Senpothia/automate-hardware/commandes/PCB_JLCPCB.pdf

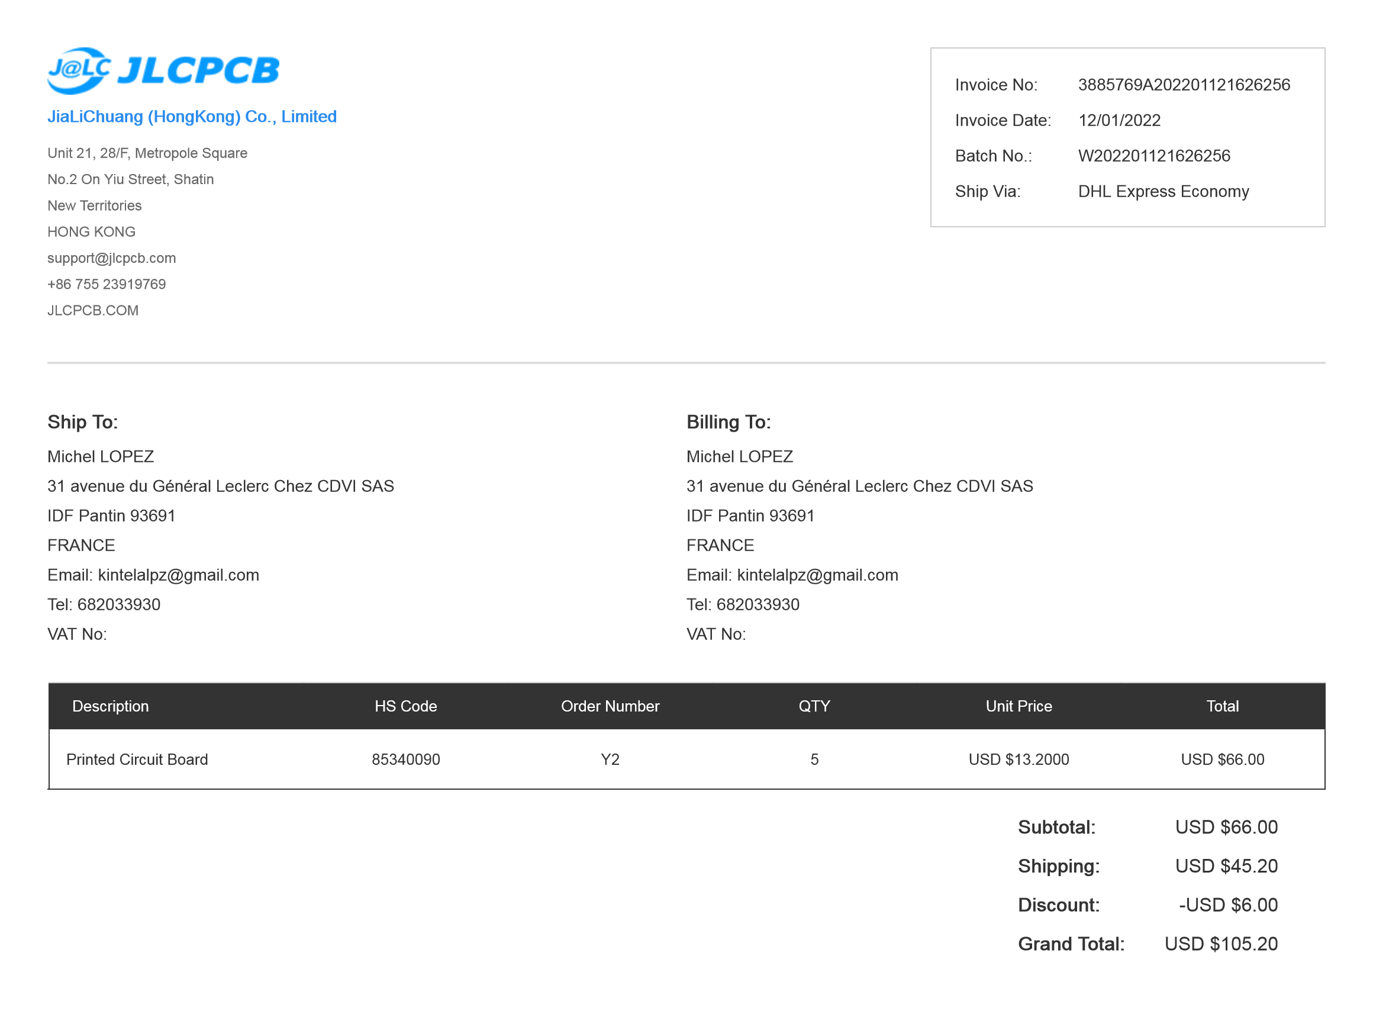
[picture p1: figure]
