Senpothia/automate-hardware/datasheet/microchip/PIC16F628A_Mod.png

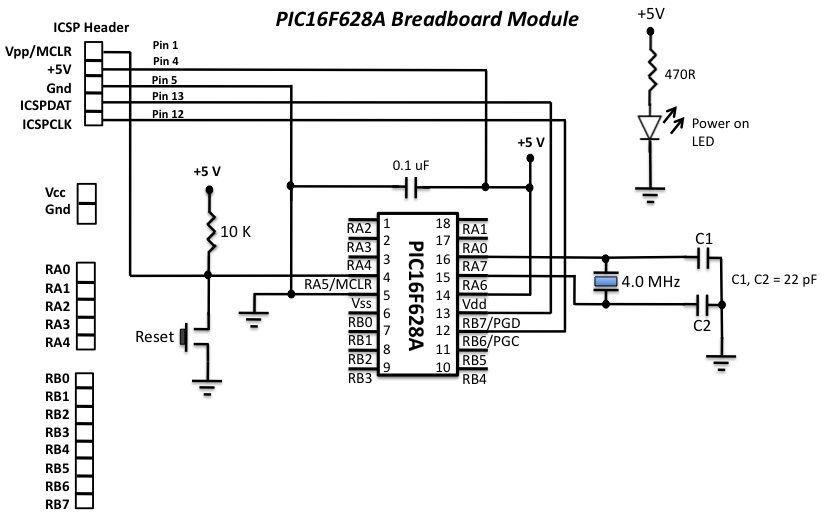
datasheet/microchip/PIC16F628A_Mod.png
