Senpothia/automate-hardware/datasheet/microchip/PICkit-ICSP-connector-to-PIC-chip-schematic.png

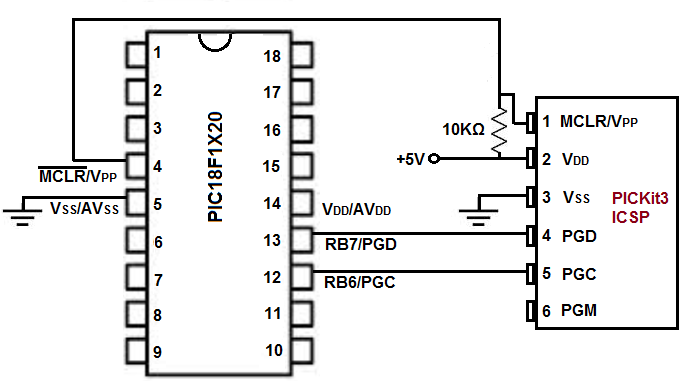
datasheet/microchip/PICkit-ICSP-connector-to-PIC-chip-schematic.png
