Senpothia/automate-hardware/version_qtfp.png

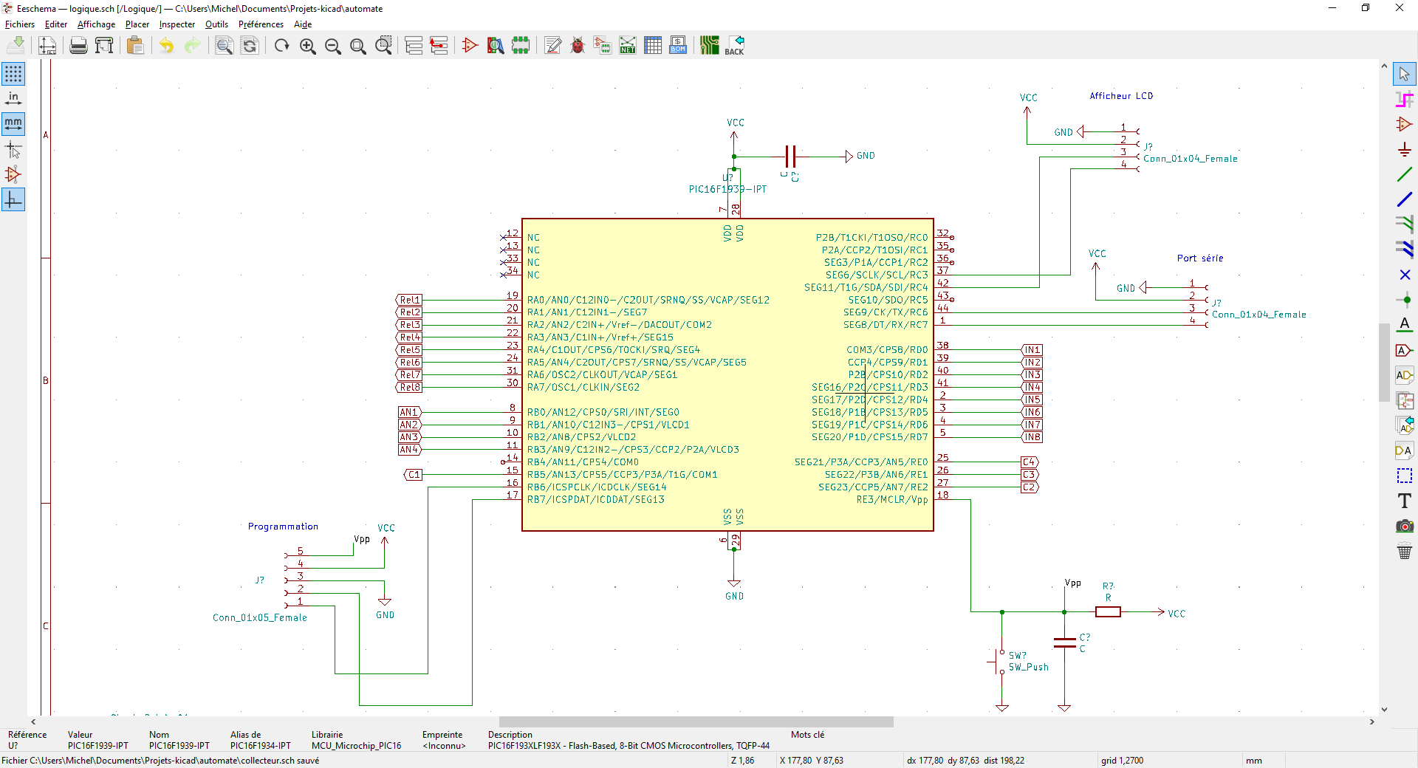
version_qtfp.png
