Senpothia/automate-hardware/brochage.ods

Label connecteur carte | Label schéma | Label carte | Pin PIC16F1939 | Interruptions | Remarques
J13 | IN1 | IN8 | 19
J14 | IN3 | IN7 | 21
J15 | IN2 | IN6 | 20
J16 | IN4 | IN5 | 22
J17 | IN5 | IN4 | 27
J18 | IN7 | IN3 | 29
J19 | IN6 | IN2 | 28
J20 | IN8 | IN1 | 30
J5 | K1 | K1 | 2
J6 | K2 | K2 | 3
J7 | K3 | K3 | 4
J8 | K4 | K4 | 5
J9 | K5 | K5 | 6
J10 | K6 | K6 | 7
J11 | K7 | K7 | 14
J12 | K8 | K8 | 13
J25-C1 | C1 | C1 | 38
J25-C2 | C2 | C2 | 10
J25-C3 | C4 | C3 | 9
J25-C4 | C3 | C4 | 8
J21 | AN1 | AN1 | 33 | INT /IOC PORTB
J22 | AN2 | AN2 | 34 | IOC PORTB
J23 | AN3 | AN3 | 35 | IOC PORTB
J24 | AN4 | AN4 | 36 | IOC PORTB
J4-pt3 | TX | RX | 25 |  | Erreur sérigraphie
J4-pt4 | RX | TX | 26 |  | Erreur sérigraphie
J3-pt4 | SCL | SCL | 18
J3-pt3 | SDA | SDA | 23
J26 – pt1 | GPIO1 | 0V | 15 |  | Erreur sérigraphie
J26 – pt2 | GPIO2 | 12V | 16 |  | Erreur sérigraphie
J26 – pt3 | GPIO3 | IO3 | 17 |  | Erreur sérigraphie
J26 – pt4 | GPIO4 | IO2 | 24 |  | Erreur sérigraphie
J26 – pt5 | +12V | IO1 | - |  | Erreur sérigraphie
 | BZ1/BZ2 | BZ1/BZ2 | 37
 | D43 | D43 | 37
J2 – pt1 |  | RB6 | 39 | IOC PORTB
J2 – pt2 |  | RB7 | 40 | IOC PORTB
