Senpothia/automate-hardware/datasheet/Panier_déc.31_1230.xls

PANIER
Ceci n'est pas une facture
31-déc.-21 12:30:27
 | N° Mouser | N° de fab. | Fabricant | N° client | Description | RoHS | Cycle de vie | Qté. | Prix (EUR) | Ext. : (EUR)
1 | 579-PIC16LF1939-I/P | PIC16LF1939-I/P | Microchip |  | Microcontrôleurs 8 bits - MCU 28KB Flash 1.8-5.5V 1KB RAM 256B EEPROM | RoHS : conforme |  | 5 | 2,63 € | 13,15 €
2 | 584-LT1376CS8#PBF | LT1376CS8#PBF | Analog Devices Inc. |  | Régulateurs de tension de commutation 500kHz 1.5A S/D Sw Reg. | RoHS : conforme |  | 4 | 7,87 € | 31,48 €
3 | 771-BC817K-16HR | BC817K-16HR | Nexperia |  | Transistors bipolaires - BJT TRANS BIPOLAR | RoHS : conforme |  | 50 | 0,173 € | 8,65 €
4 | 652-SMBJ150A-QH | SMBJ150A-QH | Bourns |  | Suppresseurs ESD / diodes TVS DIO TVS VRWM 150V 600W UNIDIR SMB AECQ | RoHS : conforme | Nouveau produit | 20 | 0,336 € | 6,72 €
5 | 512-SSA36 | SSA36 | onsemi |  | Diodes et redresseurs Schottky 3A, 60V SMA SCHOTTKY BARRIER RECTIFIER | Conforme à RoHS par dispense |  | 20 | 0,412 € | 8,24 €
En soumettant votre commande, vous acceptez ces conditions. (https://www.mouser.fr/saleterms) |  |  |  |  |  |  |  |  | Marchandise : | 68,24 €
Les prix sont ceux de la date et de l'heure indiquées. |  |  |  |  |  |  |  |  | Frais d'expédition : | 0,00 €
