Senpothia/automate-hardware/automate.kicad_pcb

## KiCad design automate.kicad_pcb (2022-02-25)

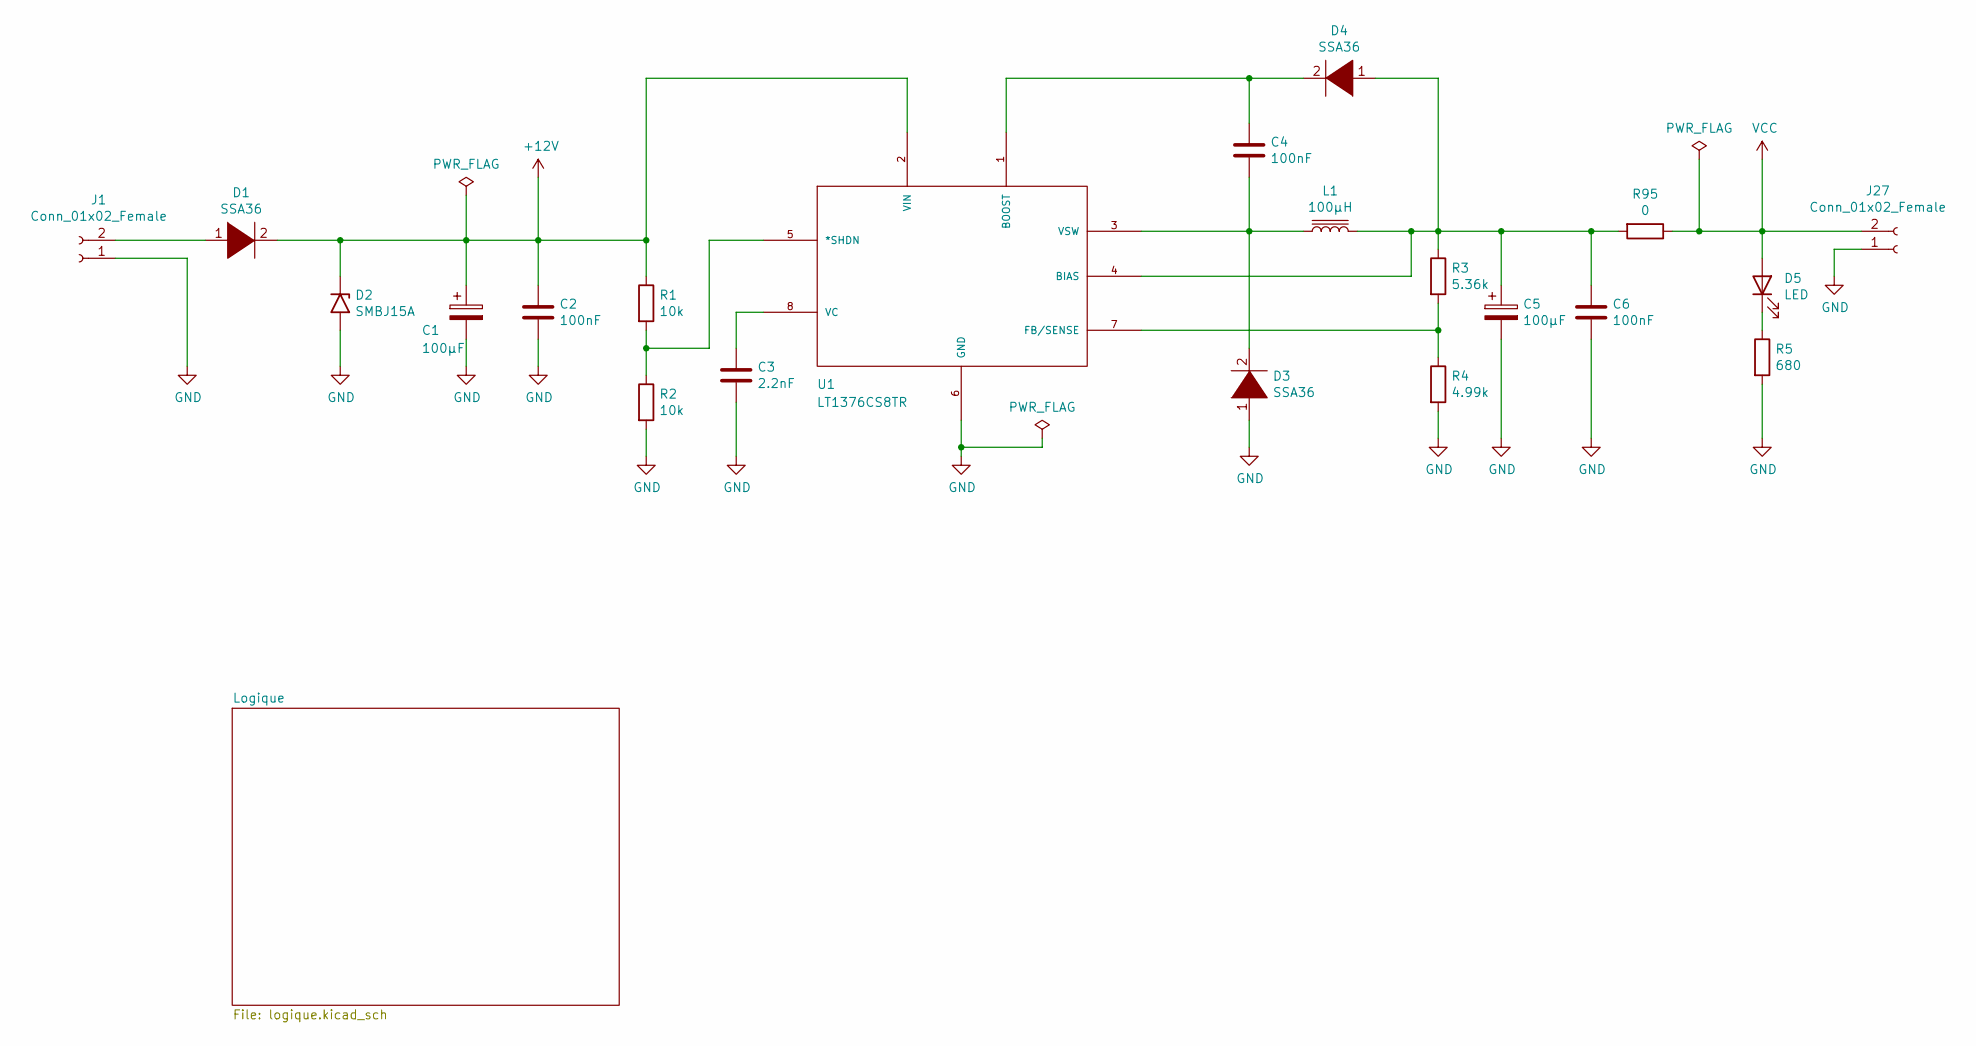
[picture p5: schematic automate.kicad_sch]

Parts:
C1, C5: 100µF; C_Elec_8x6.2
C2, C4, C6: 100nF; R_0805_2012Metric_Pad1.20x1.40mm_HandSolder
C3: 2.2nF; R_0805_2012Metric_Pad1.20x1.40mm_HandSolder
D1, D3, D4: SSA36; D_SMB_SSA36-Handsoldering
D2: SMBJ15A; D_SMB_Handsoldering
D5: LED; D_0805_2012Metric_Pad1.15x1.40mm_HandSolder
J1, J27: Conn_01x02_Female; conn-2pts-P5mm
L1: 100µH; L_Wuerth_WE-PD-Typ-LS-12x12
R1, R2: 10k; R_0805_2012Metric_Pad1.20x1.40mm_HandSolder
R3: 5.36k; R_0805_2012Metric_Pad1.20x1.40mm_HandSolder
R4: 4.99k; R_0805_2012Metric_Pad1.20x1.40mm_HandSolder
R5: 680; R_0805_2012Metric_Pad1.20x1.40mm_HandSolder
R95: 0; R_1206_3216Metric_Pad1.30x1.75mm_HandSolder
U1: LT1376CS8TR; SOIC-8_3.9x4.9mm_P1.27mm; MANUFACTURER_PART_NUMBER lt1376cs8#tr

Connections:
+12V: C1.1, C2.1, D1.2 (A), D2.1 (A1), R1.1, U1.2 (VIN); also elsewhere on the board
GND: C1.2, C2.2, C3.2, C5.2, C6.2, D2.2 (A2), D3.1 (K), J1.1, J27.1, R2.2, R4.2, R5.2, U1.6 (GND); also elsewhere on the board
unnamed: C3.1, U1.8 (VC)
unnamed: C4.1, D4.2 (A), U1.1 (BOOST)
unnamed: C4.2, D3.2 (A), L1.1, U1.3 (VSW)
unnamed: C5.1, C6.1, D4.1 (K), L1.2, R3.1, R95.2, U1.4 (BIAS)
unnamed: D1.1 (K), J1.2
unnamed: D5.1 (K), R5.1
unnamed: R1.2, R2.1, U1.5 (*SHDN)
unnamed: R3.2, R4.1, U1.7 (FB/SENSE)
VCC: D5.2 (A), J27.2, R95.1; also elsewhere on the board

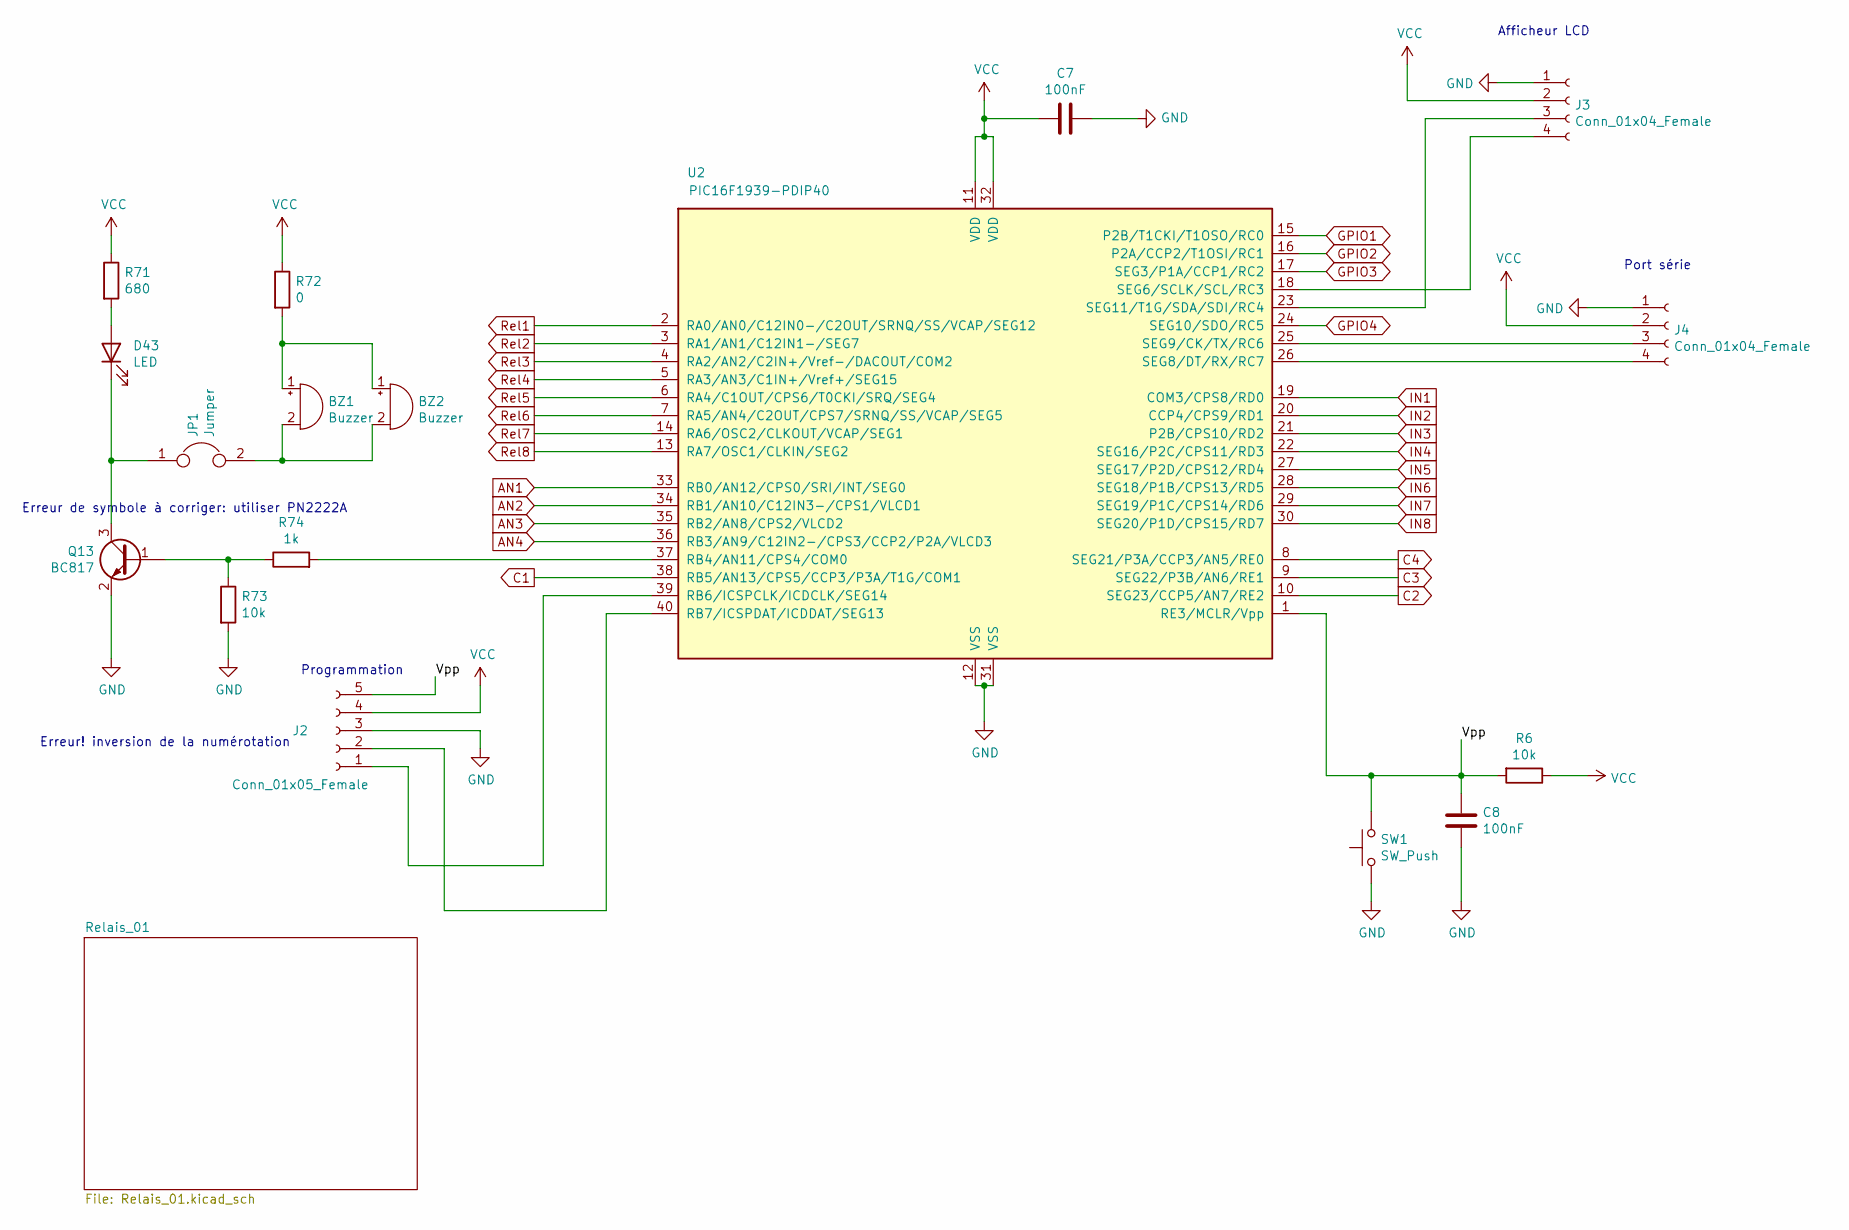
[picture p6: schematic logique.kicad_sch]

Parts:
BZ1: Buzzer; Buzzer_Mallory_AST1109MLTRQ
BZ2: Buzzer; Buzzer_12x9.5RM7.6
C7, C8: 100nF; R_0805_2012Metric_Pad1.20x1.40mm_HandSolder
D43: LED; LED_0805_2012Metric_Pad1.15x1.40mm_HandSolder
J2: Conn_01x05_Female; PinHeader_1x05_P2.54mm_Vertical
J3, J4: Conn_01x04_Female; conn-4pts-P5mm
JP1: Jumper; PinHeader_1x02_P2.54mm_Vertical
Q13: BC817; SOT-23.-BC817kicad_mod
R6, R73: 10k; R_0805_2012Metric_Pad1.20x1.40mm_HandSolder
R71: 680; R_0805_2012Metric_Pad1.20x1.40mm_HandSolder
R72: 0; R_0805_2012Metric_Pad1.20x1.40mm_HandSolder
R74: 1k; R_0805_2012Metric_Pad1.20x1.40mm_HandSolder
SW1: SW_Push; SW_PUSH_6mm_H5mm
U2: PIC16F1939-PDIP40; DIP-40_W15.24mm_LongPads

Connections:
/Logique/Vpp: C8.1, J2.5, R6.2, SW1.2, U2.1 (RE3/MCLR/Vpp)
AN1: U2.33 (RB0/AN12/CPS0/SRI/INT/SEG0); also elsewhere on the board
AN2: U2.34 (RB1/AN10/C12IN3-/CPS1/VLCD1); also elsewhere on the board
AN3: U2.35 (RB2/AN8/CPS2/VLCD2); also elsewhere on the board
AN4: U2.36 (RB3/AN9/C12IN2-/CPS3/CCP2/P2A/VLCD3); also elsewhere on the board
C1: U2.38 (RB5/AN13/CPS5/CCP3/P3A/T1G/COM1); also elsewhere on the board
C2: U2.10 (SEG23/CCP5/AN7/RE2); also elsewhere on the board
C3: U2.9 (SEG22/P3B/AN6/RE1); also elsewhere on the board
C4: U2.8 (SEG21/P3A/CCP3/AN5/RE0); also elsewhere on the board
GND: C7.1, C8.2, J2.3, J3.1, J4.1, Q13.2 (E), R73.2, SW1.1, U2.12 (VSS), U2.31 (VSS); also elsewhere on the board
GPIO1: U2.15 (P2B/T1CKI/T1OSO/RC0); also elsewhere on the board
GPIO2: U2.16 (P2A/CCP2/T1OSI/RC1); also elsewhere on the board
GPIO3: U2.17 (SEG3/P1A/CCP1/RC2); also elsewhere on the board
GPIO4: U2.24 (SEG10/SDO/RC5); also elsewhere on the board
IN1: U2.19 (COM3/CPS8/RD0); also elsewhere on the board
IN2: U2.20 (CCP4/CPS9/RD1); also elsewhere on the board
IN3: U2.21 (P2B/CPS10/RD2); also elsewhere on the board
IN4: U2.22 (SEG16/P2C/CPS11/RD3); also elsewhere on the board
IN5: U2.27 (SEG17/P2D/CPS12/RD4); also elsewhere on the board
IN6: U2.28 (SEG18/P1B/CPS13/RD5); also elsewhere on the board
IN7: U2.29 (SEG19/P1C/CPS14/RD6); also elsewhere on the board
IN8: U2.30 (SEG20/P1D/CPS15/RD7); also elsewhere on the board
unnamed: BZ1.1 (-), BZ2.1 (-), R72.2
unnamed: BZ1.2 (+), BZ2.2 (+), JP1.2
unnamed: D43.1 (K), JP1.1, Q13.3 (C)
unnamed: D43.2 (A), R71.2
unnamed: J2.1, U2.39 (RB6/ICSPCLK/ICDCLK/SEG14)
unnamed: J2.2, U2.40 (RB7/ICSPDAT/ICDDAT/SEG13)
unnamed: J3.3, U2.23 (SEG11/T1G/SDA/SDI/RC4)
unnamed: J3.4, U2.18 (SEG6/SCLK/SCL/RC3)
unnamed: J4.3, U2.25 (SEG9/CK/TX/RC6)
unnamed: J4.4, U2.26 (SEG8/DT/RX/RC7)
unnamed: Q13.1 (B), R73.1, R74.1
unnamed: R74.2, U2.37 (RB4/AN11/CPS4/COM0)
Rel1: U2.2 (RA0/AN0/C12IN0-/C2OUT/SRNQ/SS/VCAP/SEG12); also elsewhere on the board
Rel2: U2.3 (RA1/AN1/C12IN1-/SEG7); also elsewhere on the board
Rel3: U2.4 (RA2/AN2/C2IN+/Vref-/DACOUT/COM2); also elsewhere on the board
Rel4: U2.5 (RA3/AN3/C1IN+/Vref+/SEG15); also elsewhere on the board
Rel5: U2.6 (RA4/C1OUT/CPS6/T0CKI/SRQ/SEG4); also elsewhere on the board
Rel6: U2.7 (RA5/AN4/C2OUT/CPS7/SRNQ/SS/VCAP/SEG5); also elsewhere on the board
Rel7: U2.14 (RA6/OSC2/CLKOUT/VCAP/SEG1); also elsewhere on the board
Rel8: U2.13 (RA7/OSC1/CLKIN/SEG2); also elsewhere on the board
VCC: C7.2, J2.4, J3.2, J4.2, R6.1, R71.1, R72.1, U2.11 (VDD), U2.32 (VDD); also elsewhere on the board

Notes on the sheet:
Erreur! inversion de la numérotation
Afficheur LCD
Port série
Programmation
Erreur de symbole à corriger: utiliser PN2222A

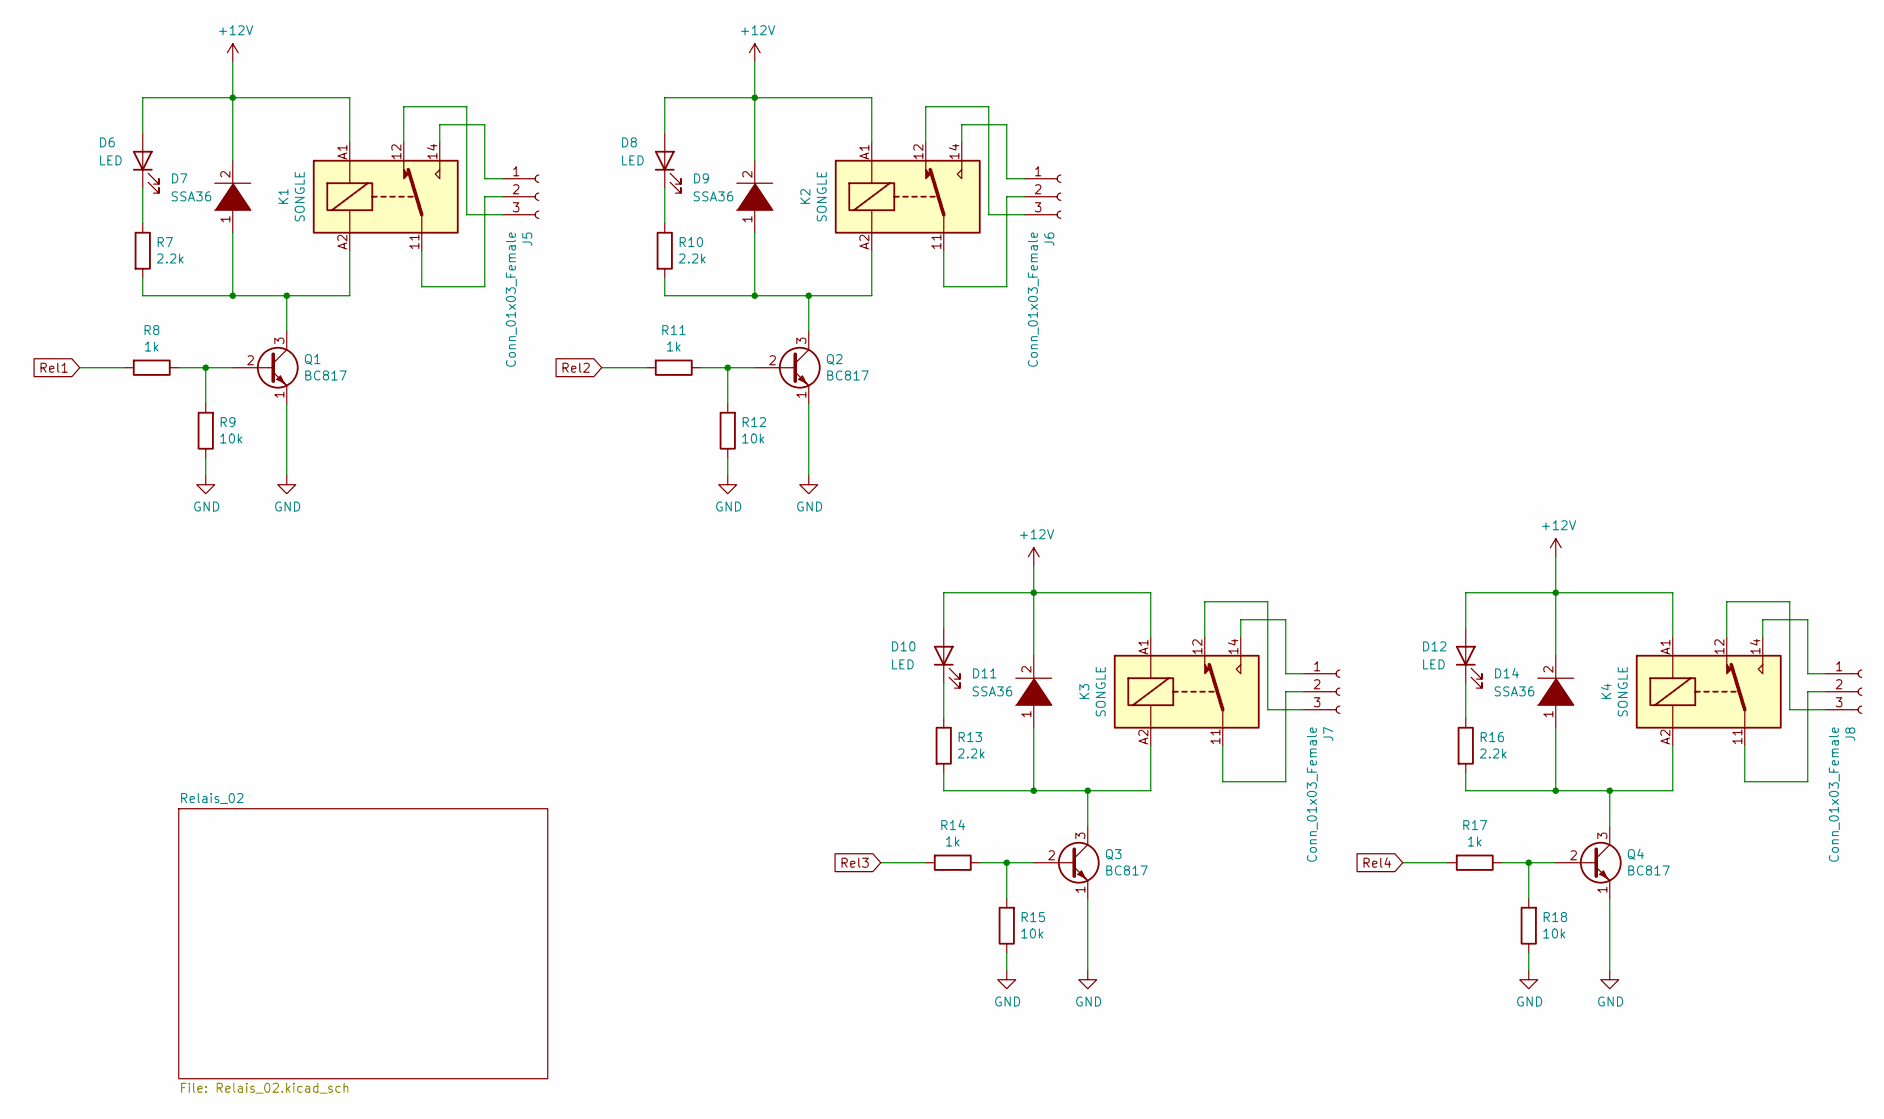
[picture p7: schematic Relais_01.kicad_sch]

Parts:
D6, D8, D10, D12: LED; D_0805_2012Metric_Pad1.15x1.40mm_HandSolder
D7, D9, D11: SSA36; D_SMB_SSA36-Handsoldering
D14: SSA36; D_SMB_Handsoldering
J5, J6, J7, J8: Conn_01x03_Female; conn-3pts-P5mm
K1, K2, K3, K4: SONGLE; Relay_SRD_Series_Form_C
Q1, Q2, Q3, Q4: BC817; SOT-23.-BC817kicad_mod
R7, R10, R13, R16: 2.2k; R_0805_2012Metric_Pad1.20x1.40mm_HandSolder
R8, R11, R14, R17: 1k; R_0805_2012Metric_Pad1.20x1.40mm_HandSolder
R9, R12, R15, R18: 10k; R_0805_2012Metric_Pad1.20x1.40mm_HandSolder

Connections:
+12V: D6.2 (A), D7.2 (A), D8.2 (A), D9.2 (A), D10.2 (A), D11.2 (A), D12.2 (A), D14.2 (A), K1.A1, K2.A1, K3.A1, K4.A1; also elsewhere on the board
GND: Q1.1 (E), Q2.1 (E), Q3.1 (E), Q4.1 (E), R9.1, R12.1, R15.1, R18.1; also elsewhere on the board
unnamed: D6.1 (K), R7.1
unnamed: D7.1 (K), K1.A2, Q1.3 (C), R7.2
unnamed: D8.1 (K), R10.1
unnamed: D9.1 (K), K2.A2, Q2.3 (C), R10.2
unnamed: D10.1 (K), R13.1
unnamed: D11.1 (K), K3.A2, Q3.3 (C), R13.2
unnamed: D12.1 (K), R16.1
unnamed: D14.1 (K), K4.A2, Q4.3 (C), R16.2
unnamed: J5.1, K1.14
unnamed: J5.2, K1.11
unnamed: J5.3, K1.12
unnamed: J6.1, K2.14
unnamed: J6.2, K2.11
unnamed: J6.3, K2.12
unnamed: J7.1, K3.14
unnamed: J7.2, K3.11
unnamed: J7.3, K3.12
unnamed: J8.1, K4.14
unnamed: J8.2, K4.11
unnamed: J8.3, K4.12
unnamed: Q1.2 (B), R8.1, R9.2
unnamed: Q2.2 (B), R11.1, R12.2
unnamed: Q3.2 (B), R14.1, R15.2
unnamed: Q4.2 (B), R17.1, R18.2
Rel1: R8.2; also elsewhere on the board
Rel2: R11.2; also elsewhere on the board
Rel3: R14.2; also elsewhere on the board
Rel4: R17.2; also elsewhere on the board

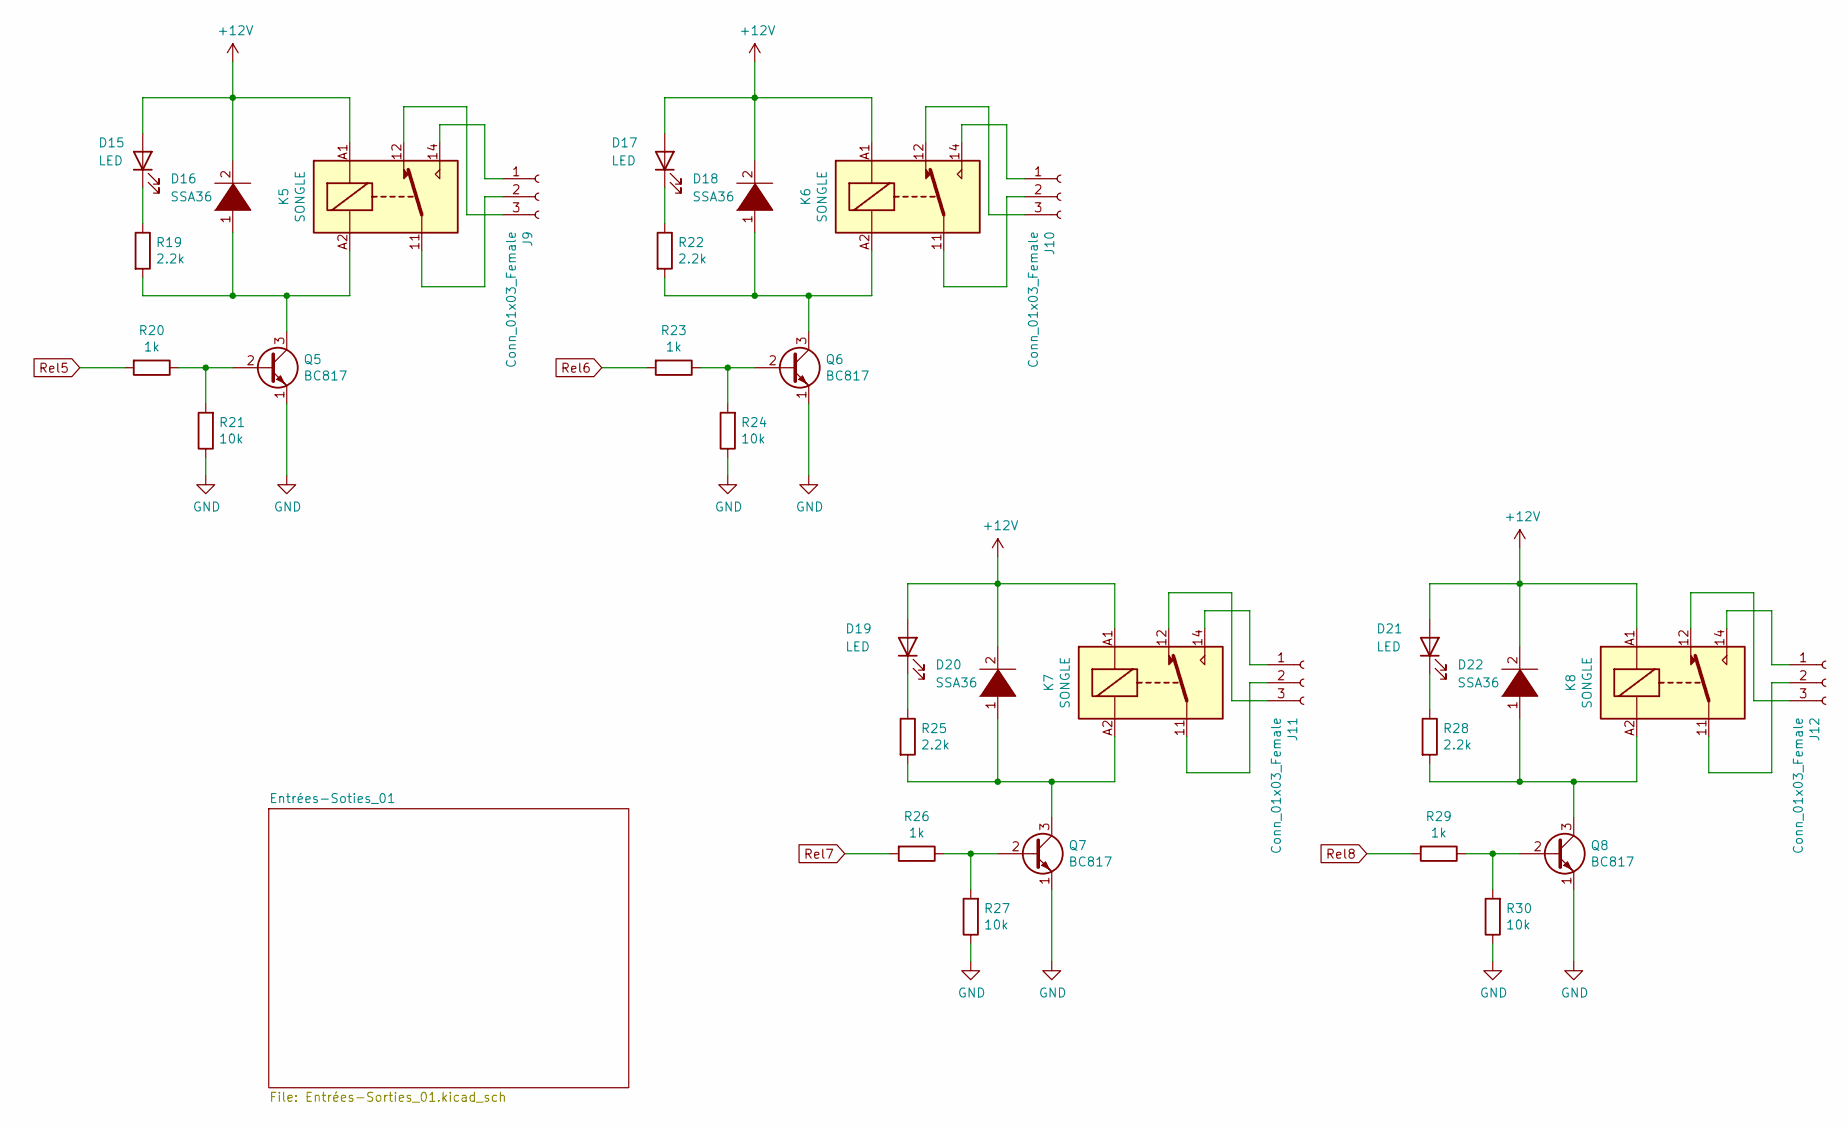
[picture p8: schematic Relais_02.kicad_sch]

Parts:
D15, D17, D19, D21: LED; D_0805_2012Metric_Pad1.15x1.40mm_HandSolder
D16, D18, D20, D22: SSA36; D_SMB_SSA36-Handsoldering
J9, J10, J11, J12: Conn_01x03_Female; conn-3pts-P5mm
K5, K6, K7, K8: SONGLE; Relay_SRD_Series_Form_C
Q5, Q6, Q7, Q8: BC817; SOT-23.-BC817kicad_mod
R19, R22, R25, R28: 2.2k; R_0805_2012Metric_Pad1.20x1.40mm_HandSolder
R20, R23, R26, R29: 1k; R_0805_2012Metric_Pad1.20x1.40mm_HandSolder
R21, R24, R27, R30: 10k; R_0805_2012Metric_Pad1.20x1.40mm_HandSolder

Connections:
+12V: D15.2 (A), D16.2 (A), D17.2 (A), D18.2 (A), D19.2 (A), D20.2 (A), D21.2 (A), D22.2 (A), K5.A1, K6.A1, K7.A1, K8.A1; also elsewhere on the board
GND: Q5.1 (E), Q6.1 (E), Q7.1 (E), Q8.1 (E), R21.1, R24.1, R27.1, R30.1; also elsewhere on the board
unnamed: D15.1 (K), R19.1
unnamed: D16.1 (K), K5.A2, Q5.3 (C), R19.2
unnamed: D17.1 (K), R22.1
unnamed: D18.1 (K), K6.A2, Q6.3 (C), R22.2
unnamed: D19.1 (K), R25.1
unnamed: D20.1 (K), K7.A2, Q7.3 (C), R25.2
unnamed: D21.1 (K), R28.1
unnamed: D22.1 (K), K8.A2, Q8.3 (C), R28.2
unnamed: J9.1, K5.14
unnamed: J9.2, K5.11
unnamed: J9.3, K5.12
unnamed: J10.1, K6.14
unnamed: J10.2, K6.11
unnamed: J10.3, K6.12
unnamed: J11.1, K7.14
unnamed: J11.2, K7.11
unnamed: J11.3, K7.12
unnamed: J12.1, K8.14
unnamed: J12.2, K8.11
unnamed: J12.3, K8.12
unnamed: Q5.2 (B), R20.1, R21.2
unnamed: Q6.2 (B), R23.1, R24.2
unnamed: Q7.2 (B), R26.1, R27.2
unnamed: Q8.2 (B), R29.1, R30.2
Rel5: R20.2; also elsewhere on the board
Rel6: R23.2; also elsewhere on the board
Rel7: R26.2; also elsewhere on the board
Rel8: R29.2; also elsewhere on the board

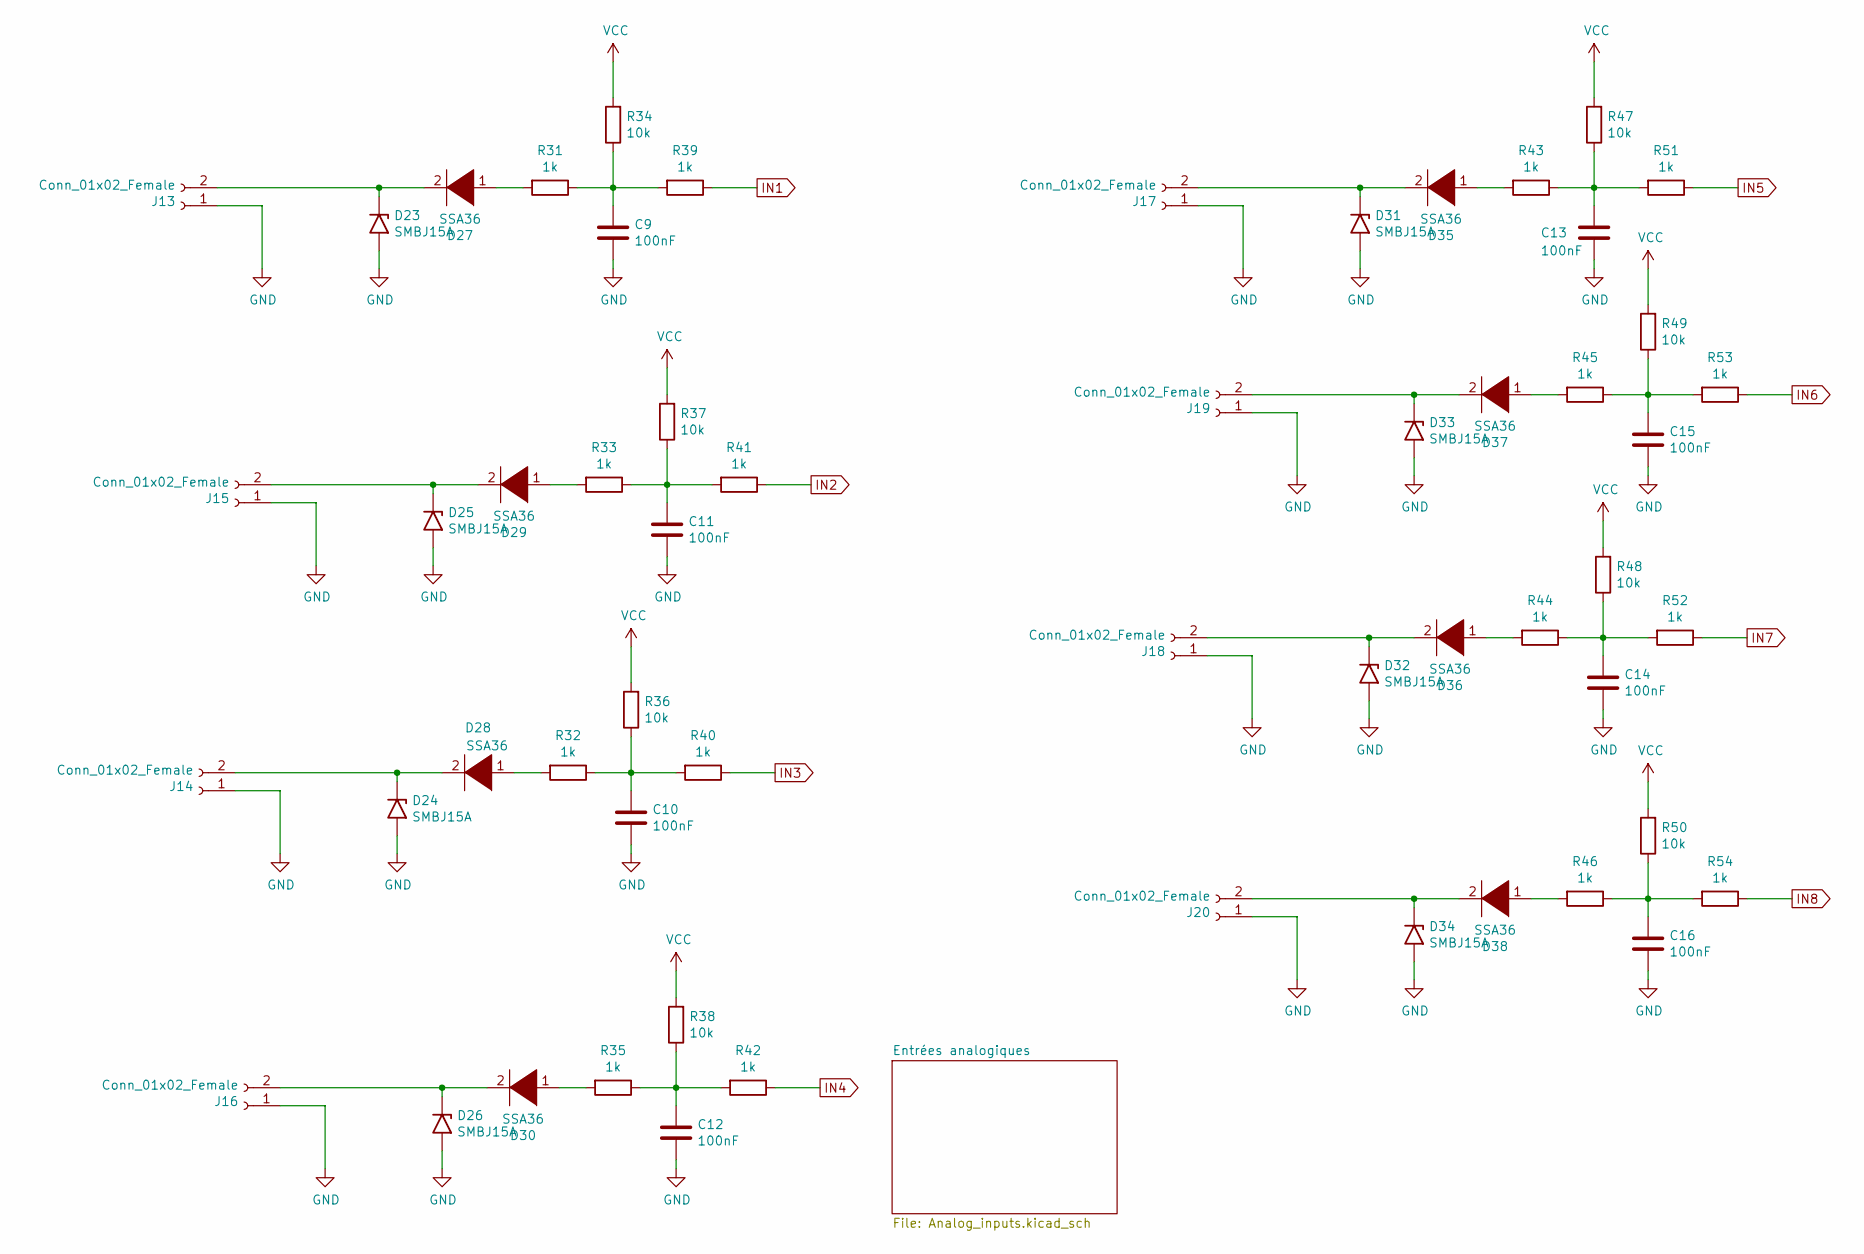
[picture p9: schematic Entrées-Sorties_01.kicad_sch]

Parts:
C9, C10, C11, C12, C13, C14, C15, C16: 100nF; R_0805_2012Metric_Pad1.20x1.40mm_HandSolder
D23, D24, D25, D26, D31, D32, D33, D34: SMBJ15A; D_SMB_Handsoldering
D27, D28, D29, D30, D35, D36, D37, D38: SSA36; D_SMB_SSA36-Handsoldering
J13, J14, J15, J16, J17, J18, J19, J20: Conn_01x02_Female; conn-2pts-P5mm
R31, R32, R33, R35, R39, R40, R41, R42, R43, R44, R45, R46, R51, R52, R53, R54: 1k; R_0805_2012Metric_Pad1.20x1.40mm_HandSolder
R34, R36, R37, R38, R47, R48, R49, R50: 10k; R_0805_2012Metric_Pad1.20x1.40mm_HandSolder

Connections:
GND: C9.2, C10.2, C11.2, C12.2, C13.2, C14.2, C15.2, C16.2, D23.2 (A2), D24.2 (A2), D25.2 (A2), D26.2 (A2), D31.2 (A2), D32.2 (A2), D33.2 (A2), D34.2 (A2), J13.1, J14.1, J15.1, J16.1, J17.1, J18.1, J19.1, J20.1; also elsewhere on the board
IN1: R39.1; also elsewhere on the board
IN2: R41.1; also elsewhere on the board
IN3: R40.1; also elsewhere on the board
IN4: R42.1; also elsewhere on the board
IN5: R51.1; also elsewhere on the board
IN6: R53.1; also elsewhere on the board
IN7: R52.1; also elsewhere on the board
IN8: R54.1; also elsewhere on the board
unnamed: C9.1, R31.1, R34.1, R39.2
unnamed: C10.1, R32.1, R36.1, R40.2
unnamed: C11.1, R33.1, R37.1, R41.2
unnamed: C12.1, R35.1, R38.1, R42.2
unnamed: C13.1, R43.1, R47.1, R51.2
unnamed: C14.1, R44.1, R48.1, R52.2
unnamed: C15.1, R45.1, R49.1, R53.2
unnamed: C16.1, R46.1, R50.1, R54.2
unnamed: D23.1 (A1), D27.2 (A), J13.2
unnamed: D24.1 (A1), D28.2 (A), J14.2
unnamed: D25.1 (A1), D29.2 (A), J15.2
unnamed: D26.1 (A1), D30.2 (A), J16.2
unnamed: D27.1 (K), R31.2
unnamed: D28.1 (K), R32.2
unnamed: D29.1 (K), R33.2
unnamed: D30.1 (K), R35.2
unnamed: D31.1 (A1), D35.2 (A), J17.2
unnamed: D32.1 (A1), D36.2 (A), J18.2
unnamed: D33.1 (A1), D37.2 (A), J19.2
unnamed: D34.1 (A1), D38.2 (A), J20.2
unnamed: D35.1 (K), R43.2
unnamed: D36.1 (K), R44.2
unnamed: D37.1 (K), R45.2
unnamed: D38.1 (K), R46.2
VCC: R34.2, R36.2, R37.2, R38.2, R47.2, R48.2, R49.2, R50.2; also elsewhere on the board

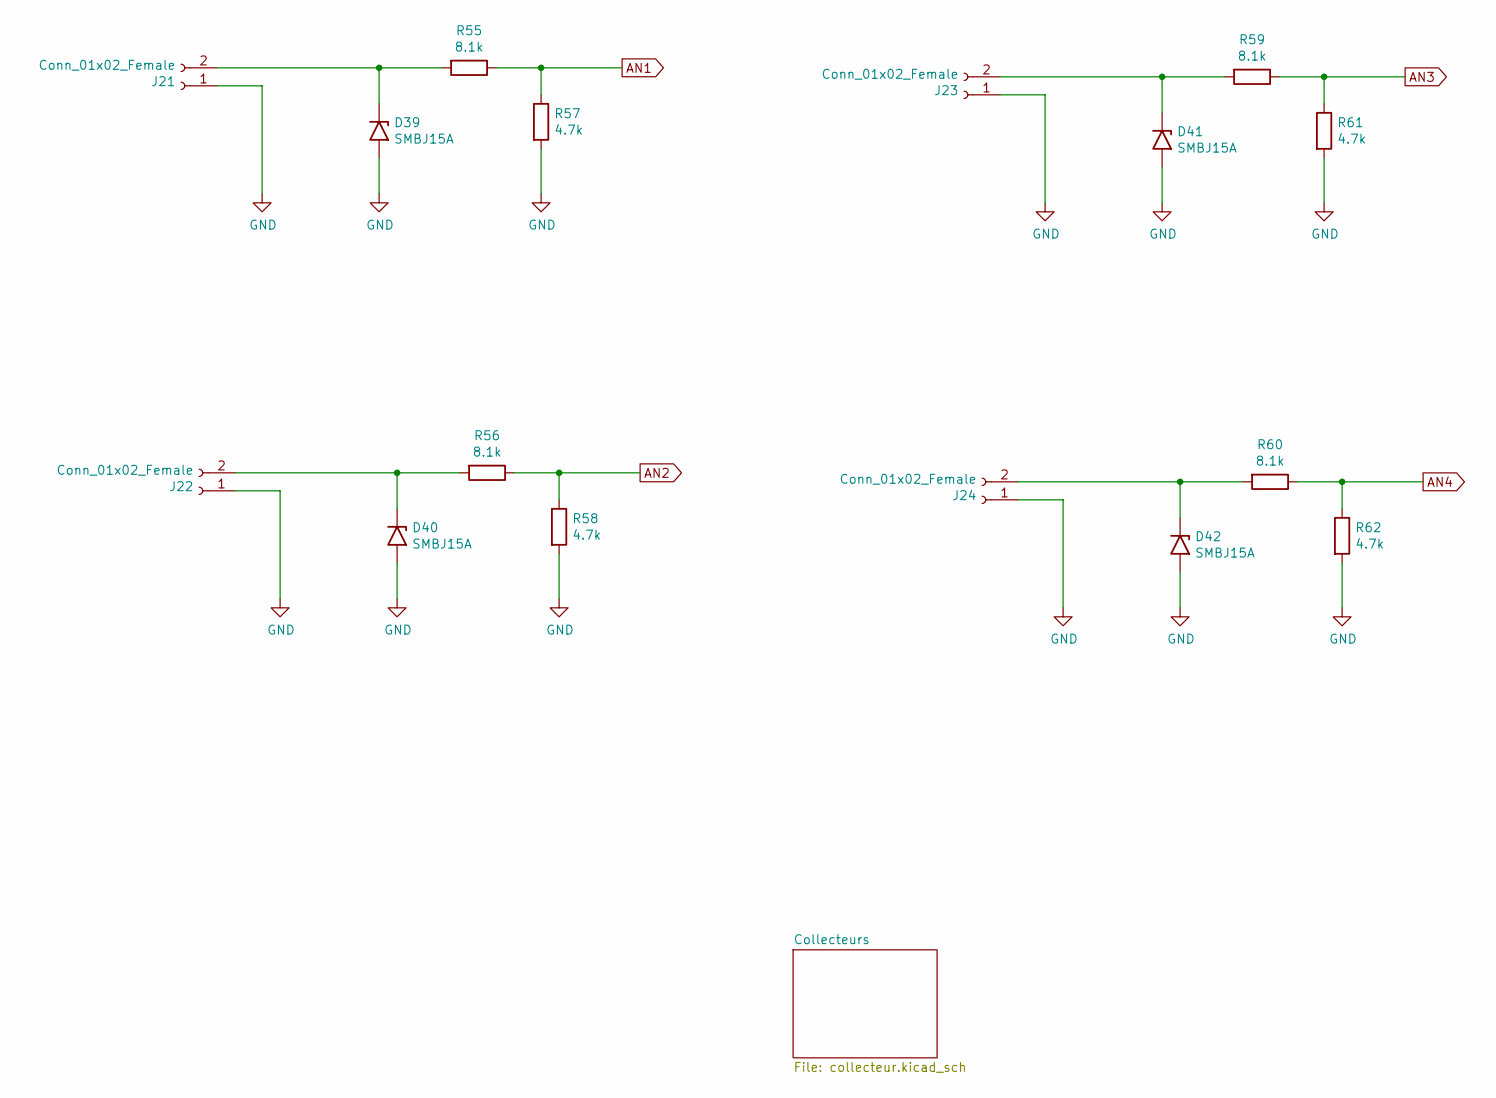
[picture p10: schematic Analog_inputs.kicad_sch]

Parts:
D39, D40, D41, D42: SMBJ15A; D_SMB_Handsoldering
J21, J22, J23, J24: Conn_01x02_Female; conn-2pts-P5mm
R55, R56, R59, R60: 8.1k; R_0805_2012Metric_Pad1.20x1.40mm_HandSolder
R57, R58, R61, R62: 4.7k; R_0805_2012Metric_Pad1.20x1.40mm_HandSolder

Connections:
AN1: R55.1, R57.1; also elsewhere on the board
AN2: R56.1, R58.1; also elsewhere on the board
AN3: R59.1, R61.1; also elsewhere on the board
AN4: R60.1, R62.1; also elsewhere on the board
GND: D39.2 (A2), D40.2 (A2), D41.2 (A2), D42.2 (A2), J21.1, J22.1, J23.1, J24.1, R57.2, R58.2, R61.2, R62.2; also elsewhere on the board
unnamed: D39.1 (A1), J21.2, R55.2
unnamed: D40.1 (A1), J22.2, R56.2
unnamed: D41.1 (A1), J23.2, R59.2
unnamed: D42.1 (A1), J24.2, R60.2

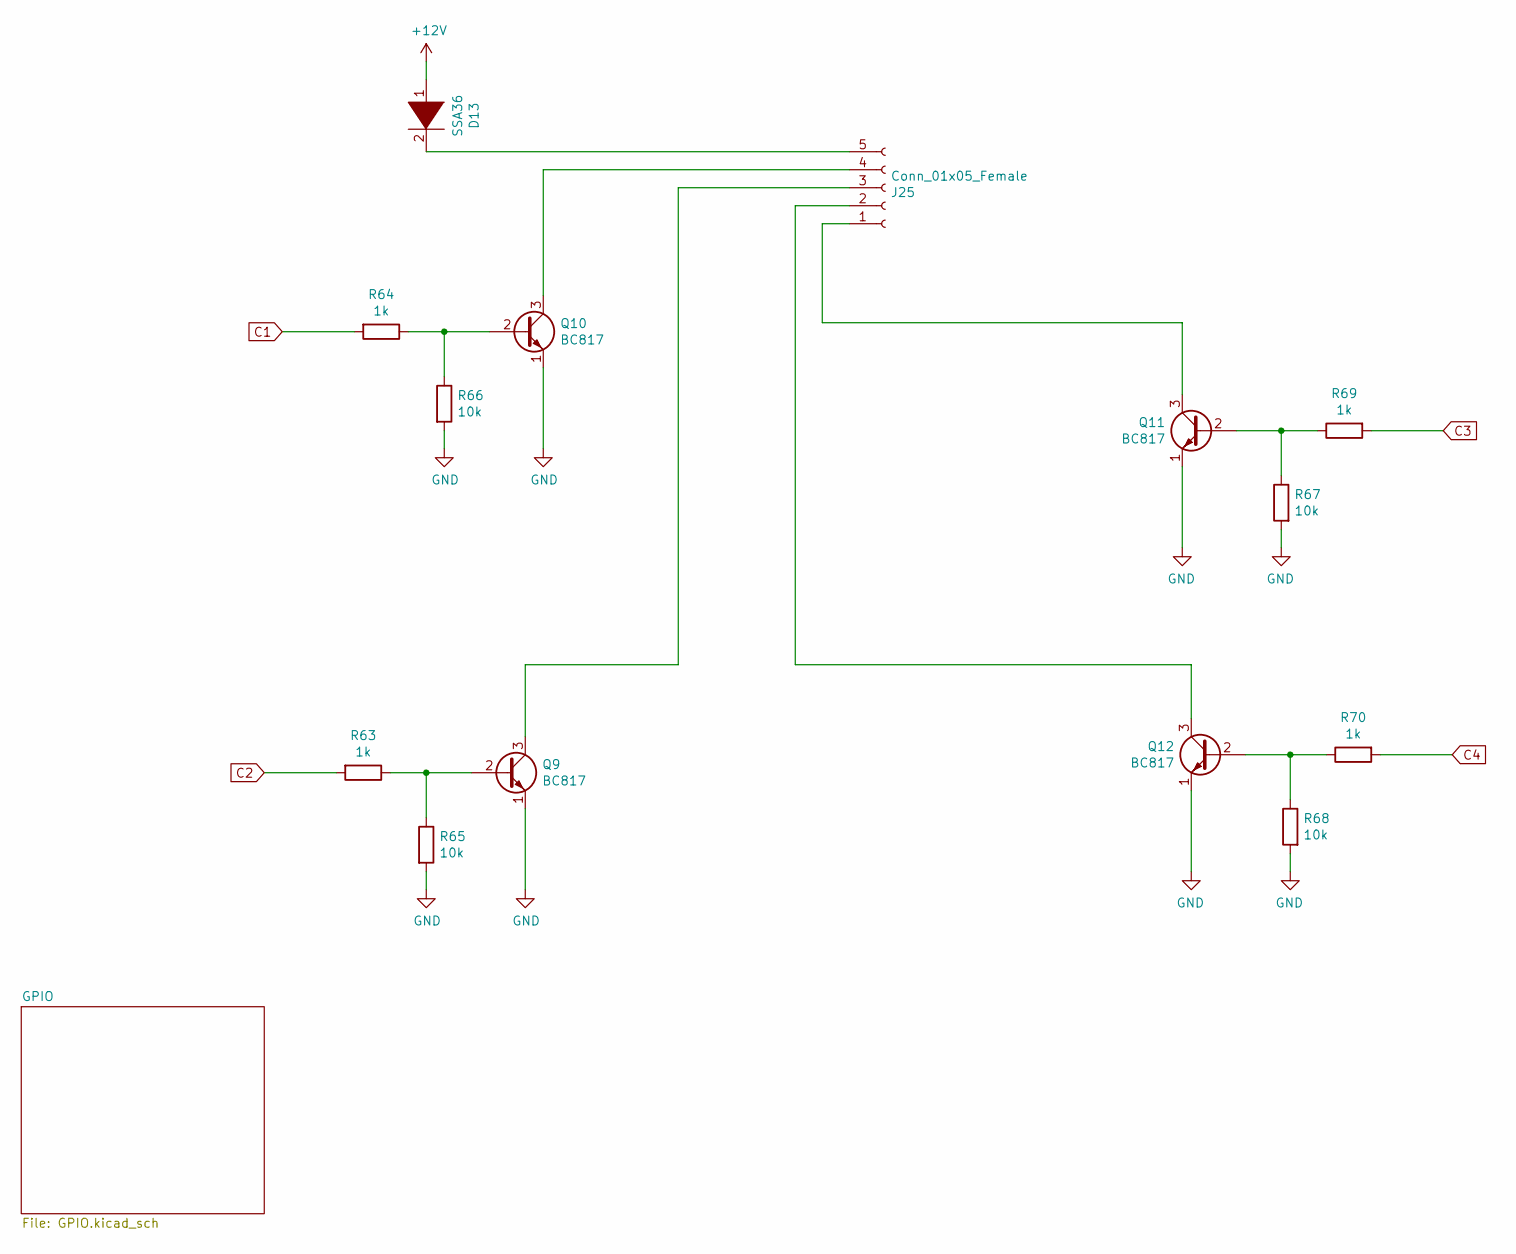
[picture p11: schematic collecteur.kicad_sch]

Parts:
D13: SSA36; D_SMB_SSA36-Handsoldering
J25: Conn_01x05_Female; conn-5pts-P5mm
Q9, Q10, Q11, Q12: BC817; SOT-23.-BC817kicad_mod
R63, R64, R69, R70: 1k; R_0805_2012Metric_Pad1.20x1.40mm_HandSolder
R65, R66, R67, R68: 10k; R_0805_2012Metric_Pad1.20x1.40mm_HandSolder

Connections:
+12V: D13.1 (K); also elsewhere on the board
C1: R64.2; also elsewhere on the board
C2: R63.2; also elsewhere on the board
C3: R69.2; also elsewhere on the board
C4: R70.2; also elsewhere on the board
GND: Q9.1 (E), Q10.1 (E), Q11.1 (E), Q12.1 (E), R65.2, R66.2, R67.2, R68.2; also elsewhere on the board
unnamed: D13.2 (A), J25.5
unnamed: J25.1, Q11.3 (C)
unnamed: J25.2, Q12.3 (C)
unnamed: J25.3, Q9.3 (C)
unnamed: J25.4, Q10.3 (C)
unnamed: Q9.2 (B), R63.1, R65.1
unnamed: Q10.2 (B), R64.1, R66.1
unnamed: Q11.2 (B), R67.1, R69.1
unnamed: Q12.2 (B), R68.1, R70.1
