Senpothia/automate-hardware/automate.kicad_pcb

## KiCad design automate.kicad_pcb (continued)

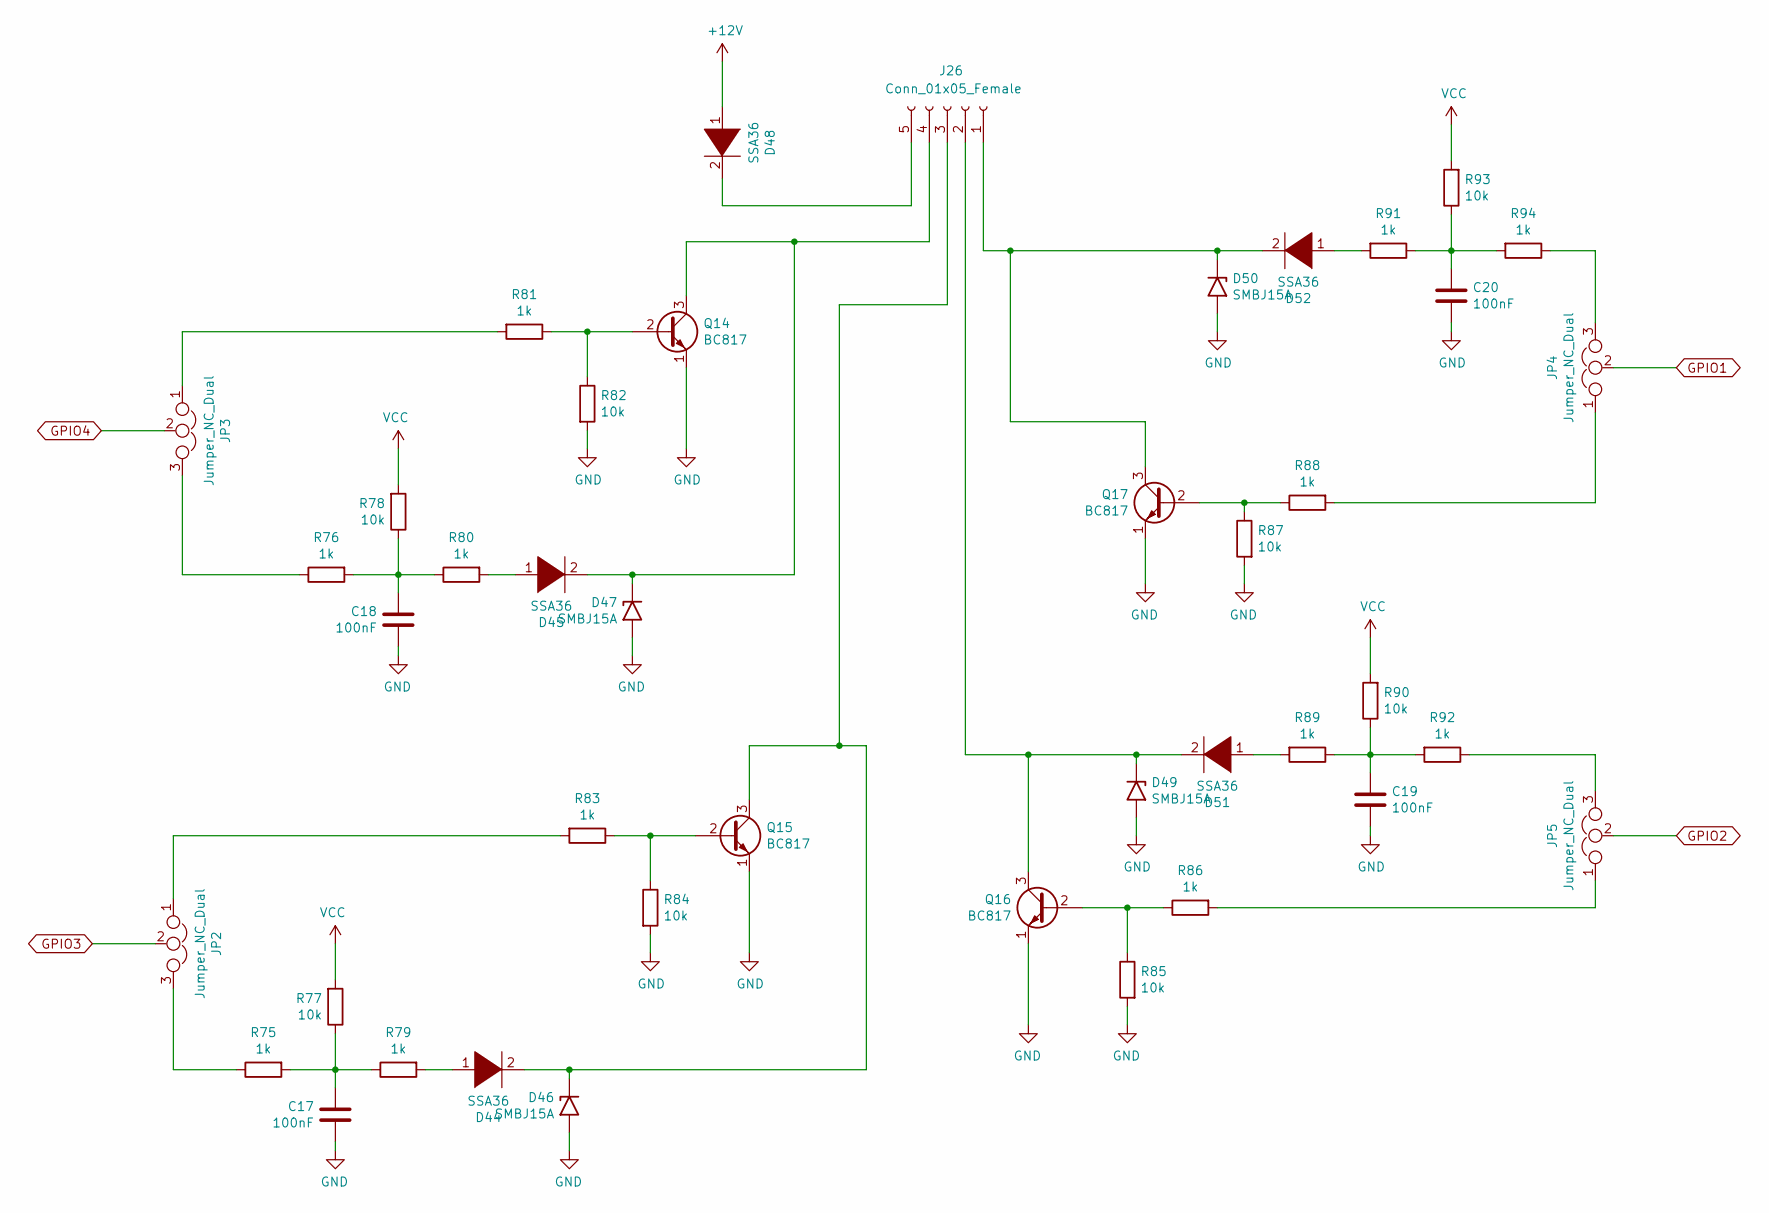
[picture p12: schematic GPIO.kicad_sch]

Parts:
C17, C18, C19, C20: 100nF; R_0805_2012Metric_Pad1.20x1.40mm_HandSolder
D44, D45, D48, D51, D52: SSA36; D_SMB_SSA36-Handsoldering
D46, D47, D49, D50: SMBJ15A; D_SMB_Handsoldering
J26: Conn_01x05_Female; conn-5pts-P5mm
JP2, JP3, JP4, JP5: Jumper_NC_Dual; PinHeader_1x03_P2.54mm_Vertical
Q14, Q15, Q16, Q17: BC817; SOT-23.-BC817kicad_mod
R75, R76, R79, R80, R81, R83, R86, R88, R89, R91, R92, R94: 1k; R_0805_2012Metric_Pad1.20x1.40mm_HandSolder
R77, R78, R82, R84, R85, R87, R90, R93: 10k; R_0805_2012Metric_Pad1.20x1.40mm_HandSolder

Connections:
+12V: D48.1 (K); also elsewhere on the board
GND: C17.2, C18.2, C19.2, C20.2, D46.2 (A2), D47.2 (A2), D49.2 (A2), D50.2 (A2), Q14.1 (E), Q15.1 (E), Q16.1 (E), Q17.1 (E), R82.2, R84.2, R85.2, R87.2; also elsewhere on the board
GPIO1: JP4.2; also elsewhere on the board
GPIO2: JP5.2; also elsewhere on the board
GPIO3: JP2.2; also elsewhere on the board
GPIO4: JP3.2; also elsewhere on the board
unnamed: C17.1, R75.2, R77.1, R79.1
unnamed: C18.1, R76.2, R78.1, R80.1
unnamed: C19.1, R89.1, R90.1, R92.2
unnamed: C20.1, R91.1, R93.1, R94.2
unnamed: D44.1 (K), R79.2
unnamed: D44.2 (A), D46.1 (A1), J26.3, Q15.3 (C)
unnamed: D45.1 (K), R80.2
unnamed: D45.2 (A), D47.1 (A1), J26.4, Q14.3 (C)
unnamed: D48.2 (A), J26.5
unnamed: D49.1 (A1), D51.2 (A), J26.2, Q16.3 (C)
unnamed: D50.1 (A1), D52.2 (A), J26.1, Q17.3 (C)
unnamed: D51.1 (K), R89.2
unnamed: D52.1 (K), R91.2
unnamed: JP2.1, R83.2
unnamed: JP2.3, R75.1
unnamed: JP3.1, R81.2
unnamed: JP3.3, R76.1
unnamed: JP4.1, R88.2
unnamed: JP4.3, R94.1
unnamed: JP5.1, R86.2
unnamed: JP5.3, R92.1
unnamed: Q14.2 (B), R81.1, R82.1
unnamed: Q15.2 (B), R83.1, R84.1
unnamed: Q16.2 (B), R85.1, R86.1
unnamed: Q17.2 (B), R87.1, R88.1
VCC: R77.2, R78.2, R90.2, R93.2; also elsewhere on the board

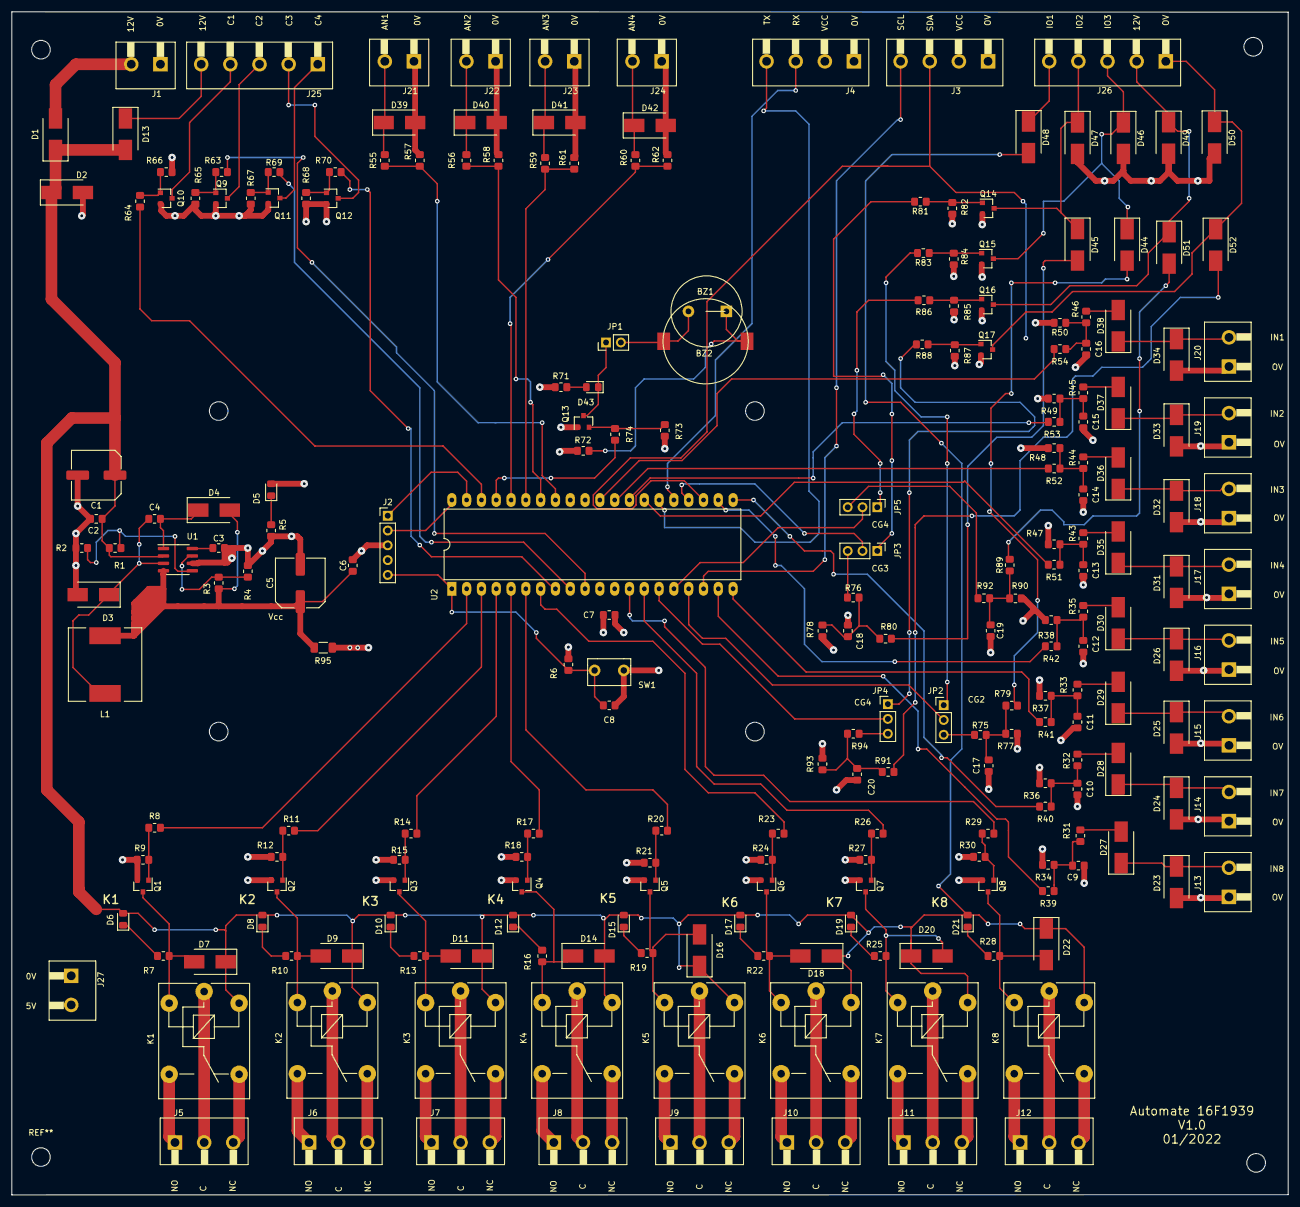
[picture p13: board automate.kicad_pcb from above]

Board: 4 copper layers, 219.0 x 203.0 mm, 230 parts (0 on the bottom side), 162 nets.
